Luke-Neumann/RV_Power_Meter/combined.pdf

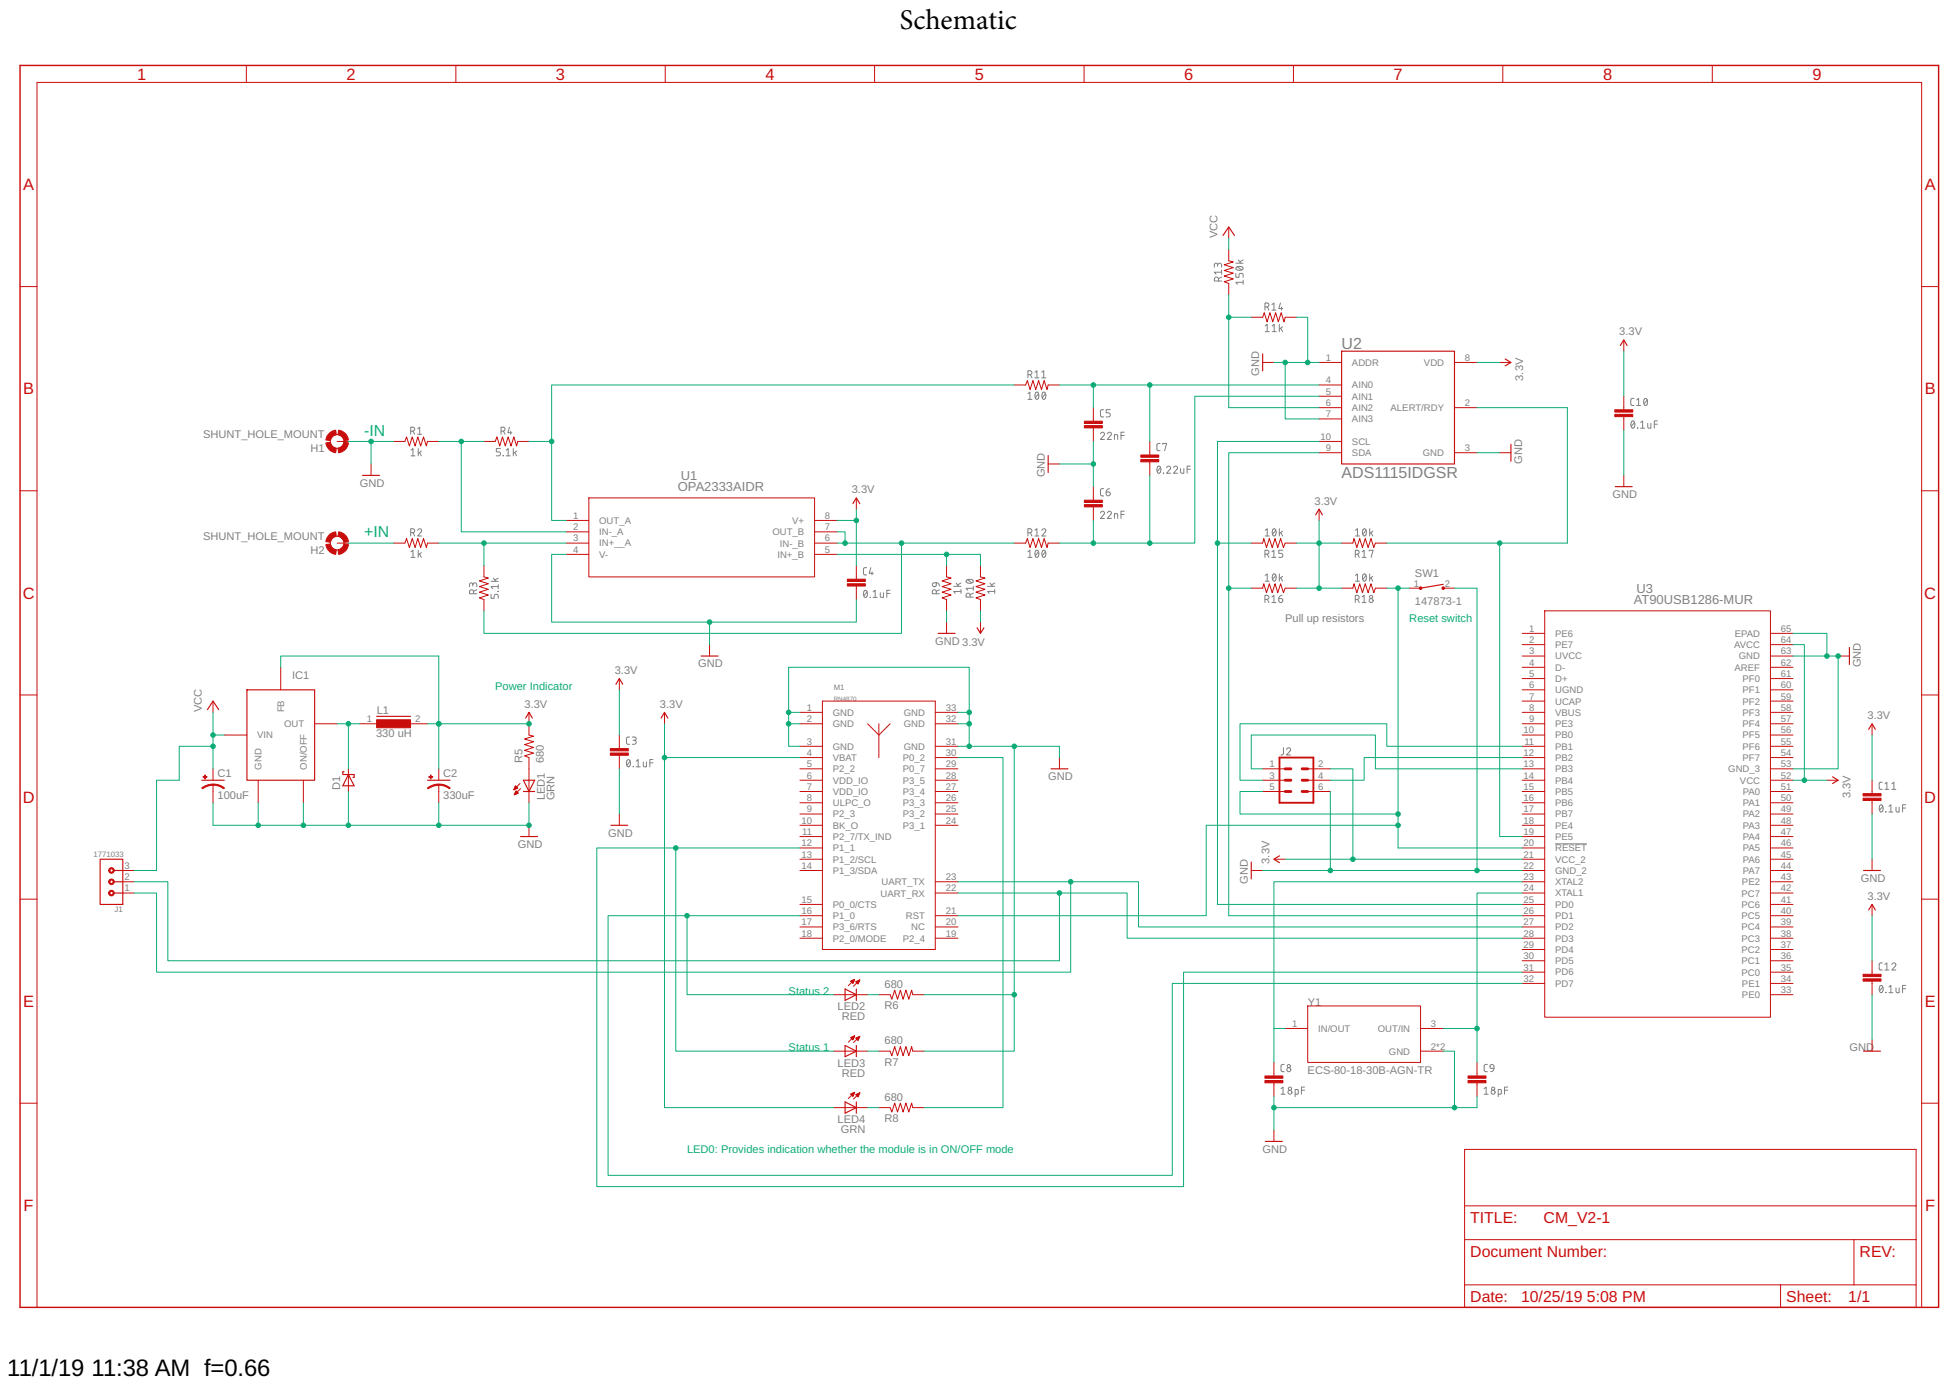
[picture p1: page 1]

LED0: Provides indication whether the module is in ON/OFF mode

Document Number: | REV:

Date: 10/25/19 5:08 PM | Sheet: 1/1

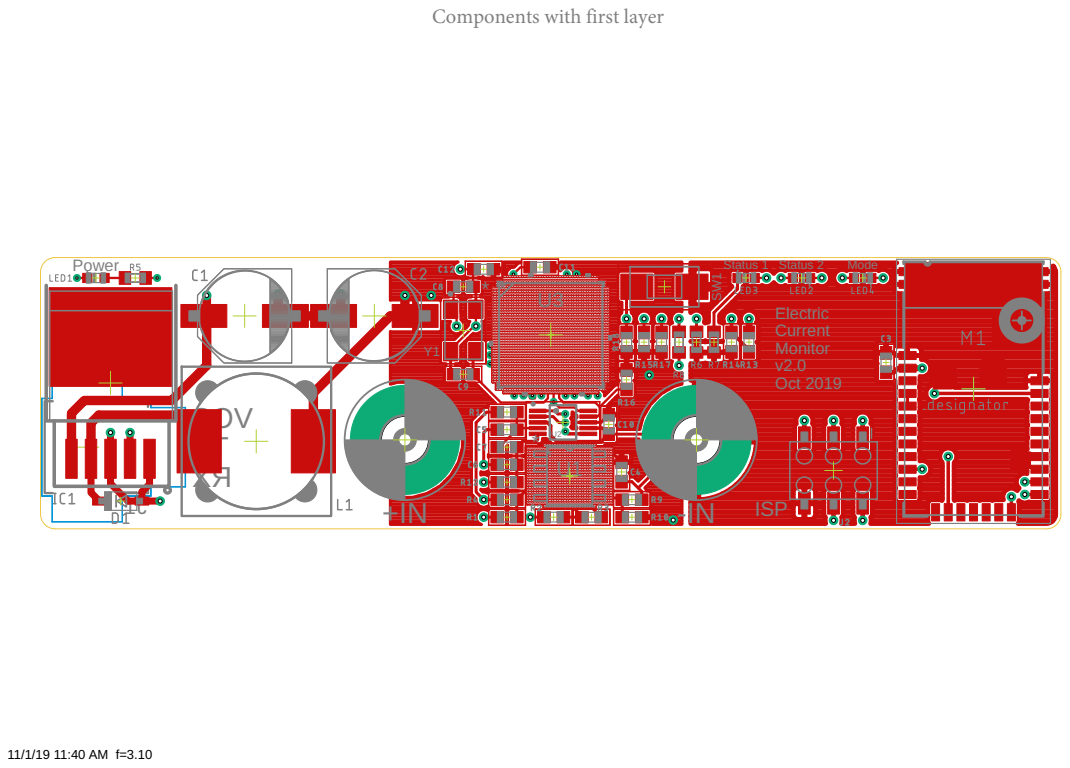
[picture p2: page 2]

Components with first layer

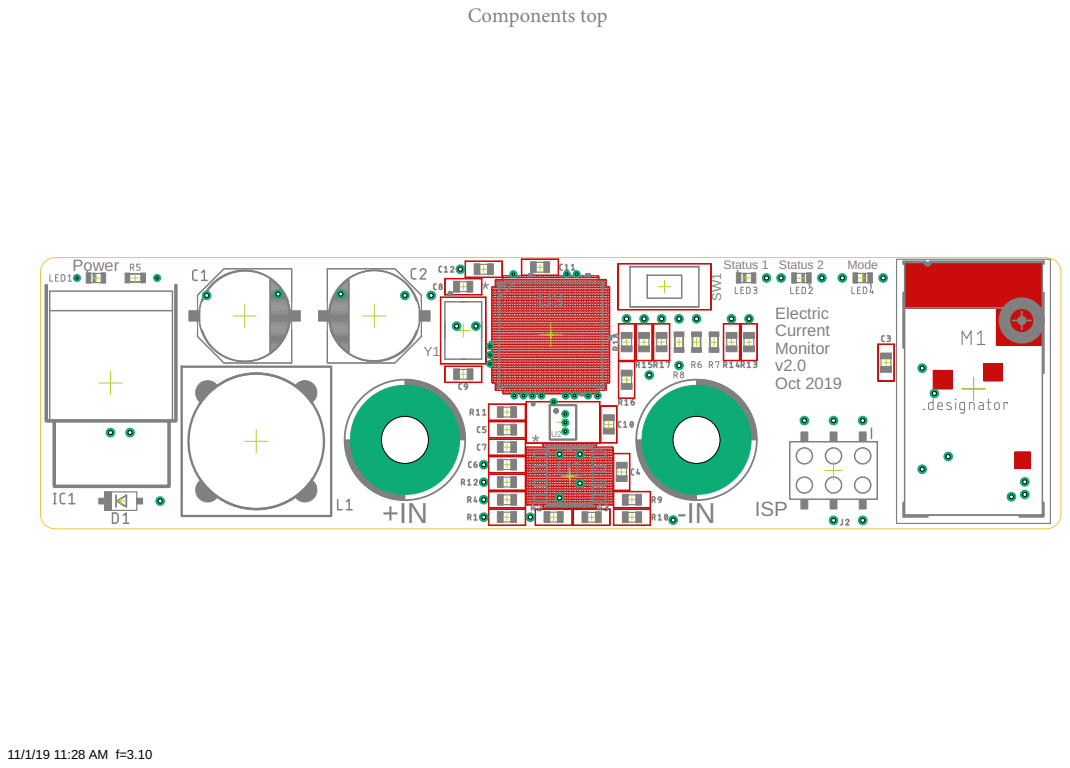
[picture p3: page 3]

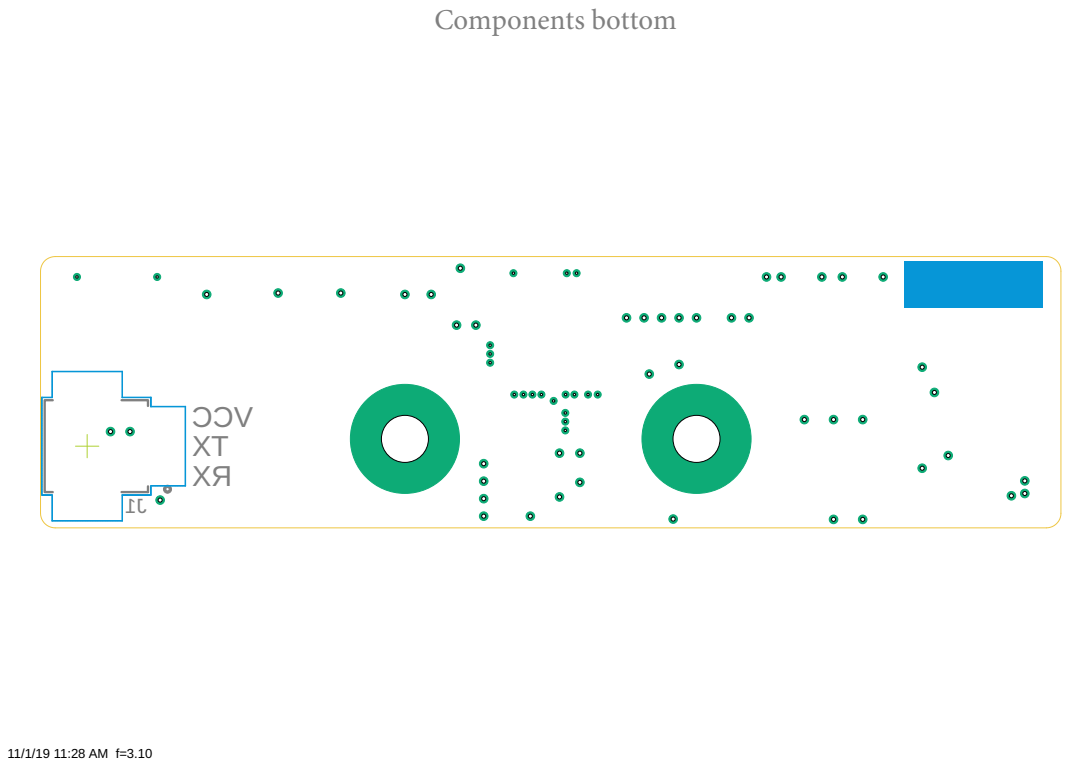
[picture p4: page 4]

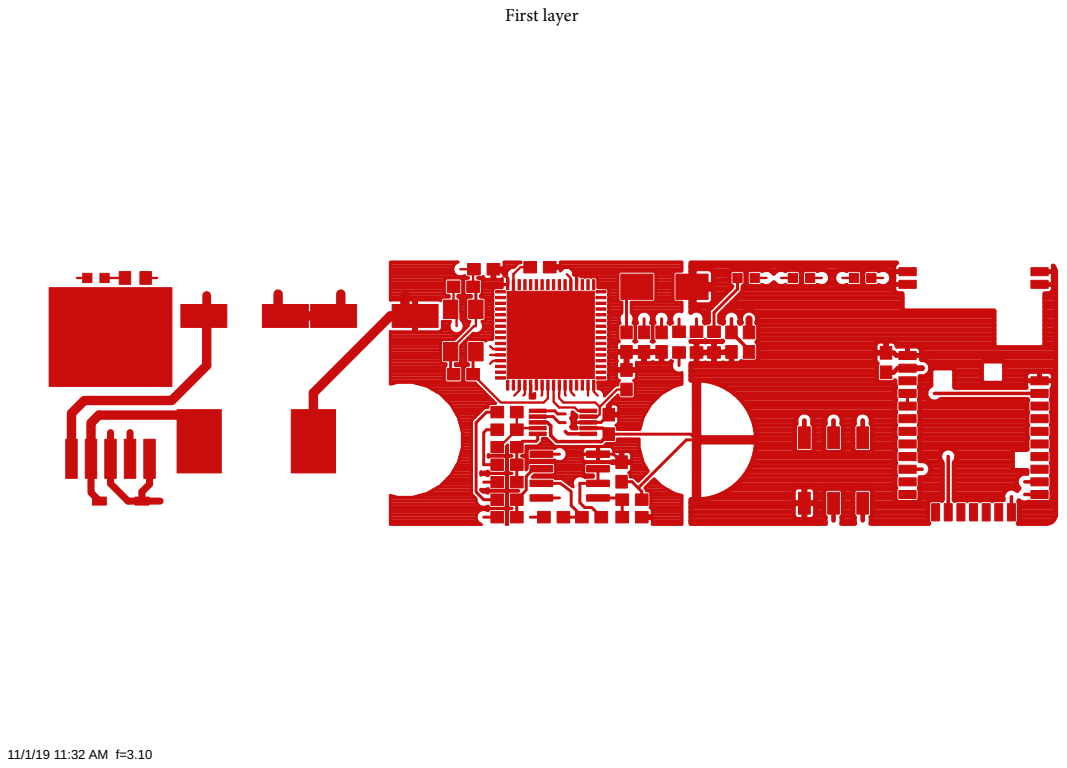
[picture p5: page 5]

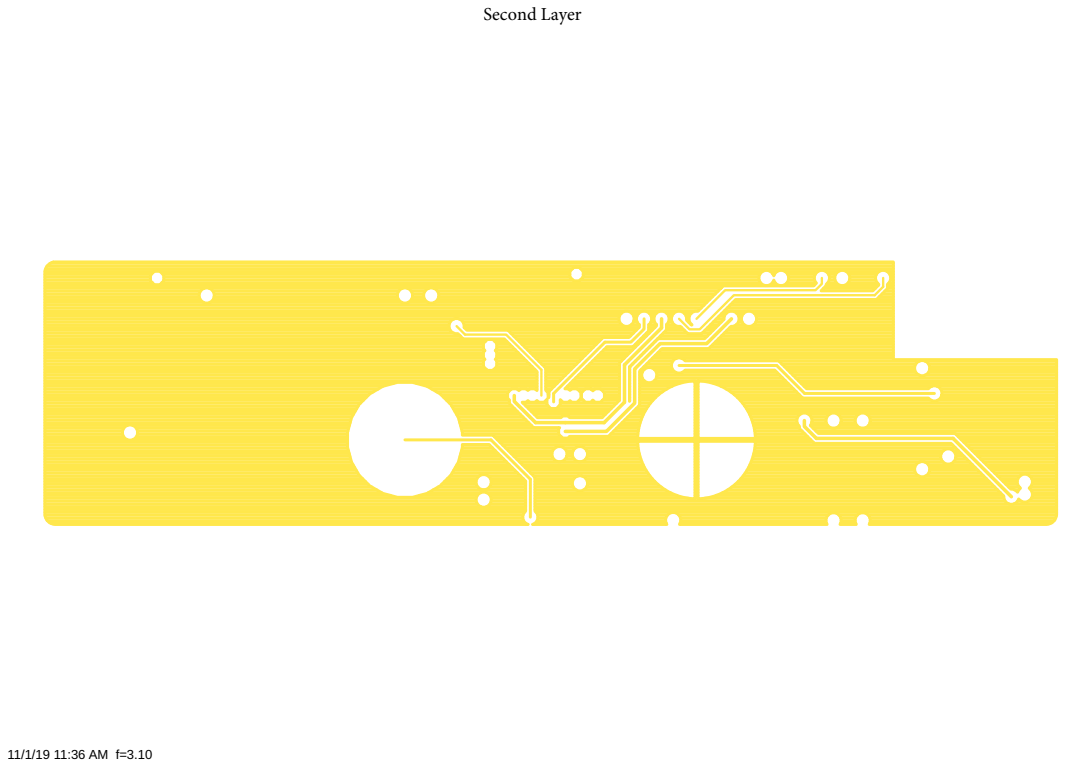
[picture p6: page 6]

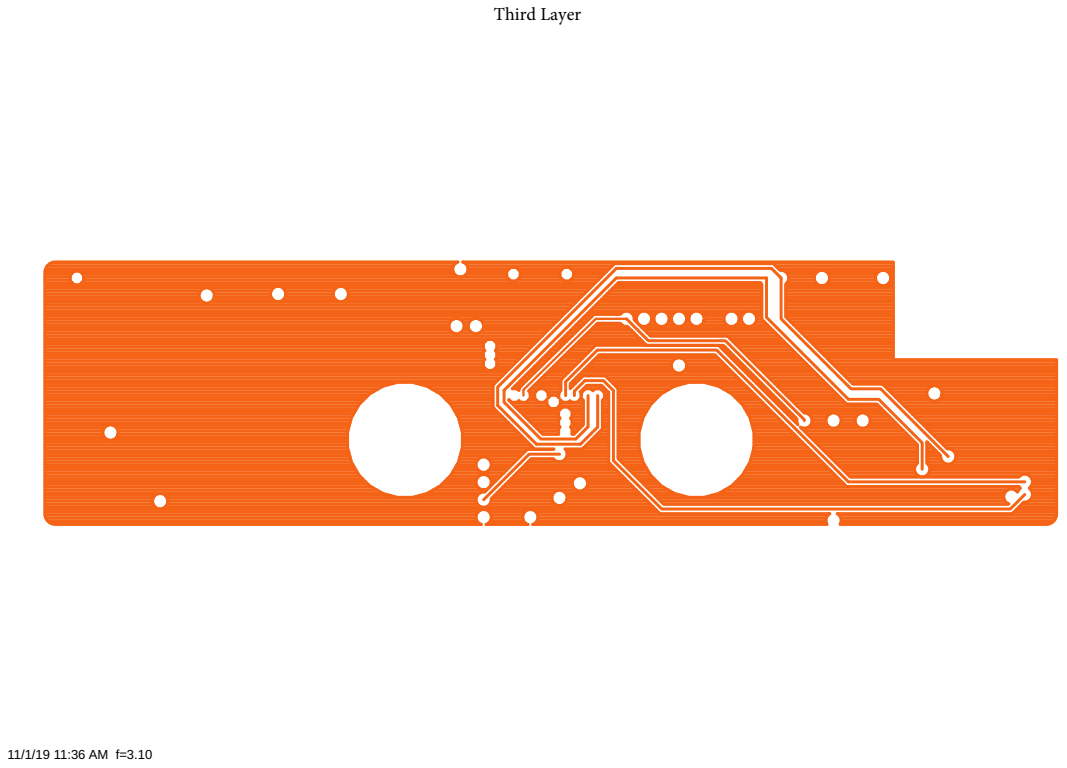
[picture p7: page 7]

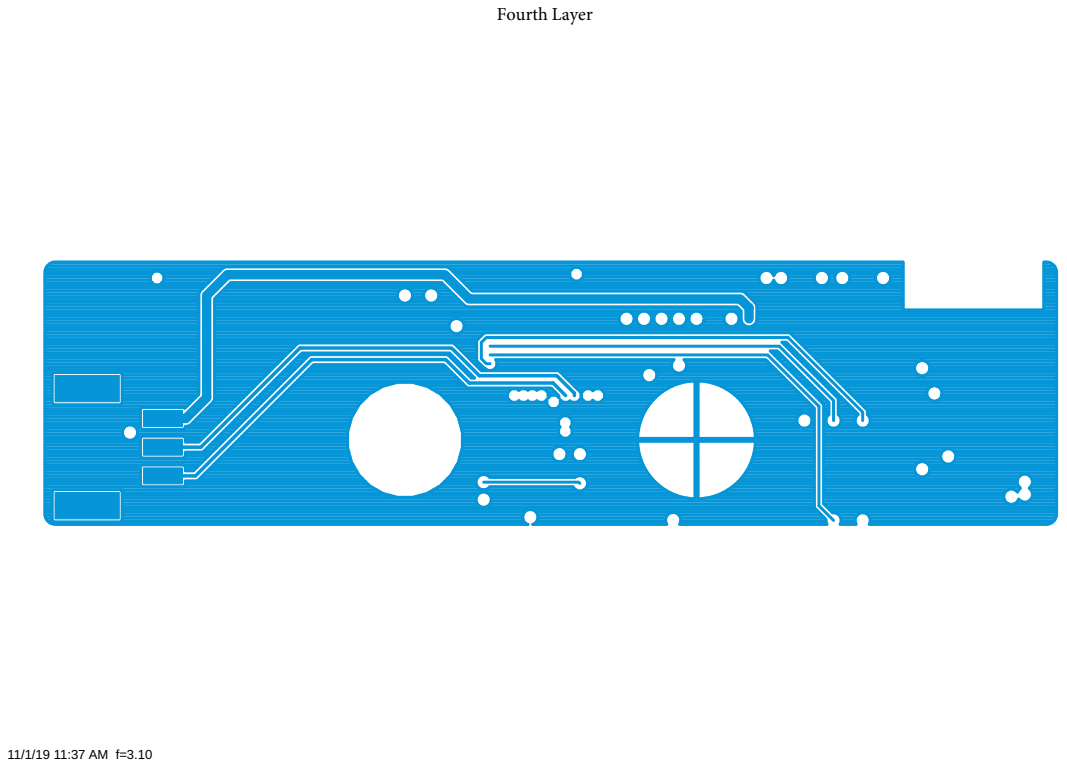
[picture p8: page 8]
